kicksat/sprite/Hardware/Sprite_Files/Sprite_Solar_Cells.jpg

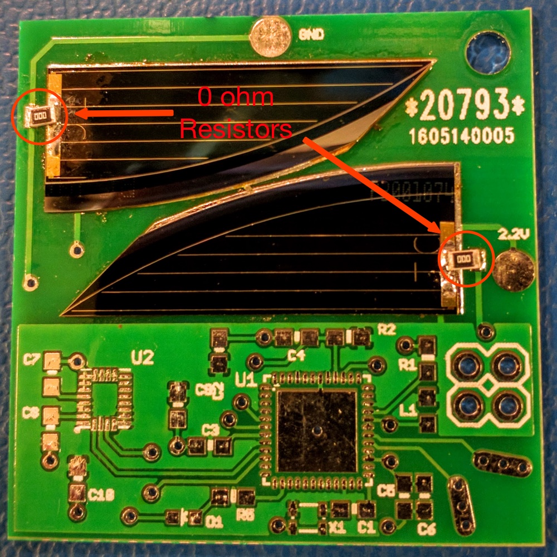
Hardware/Sprite_Files/Sprite_Solar_Cells.jpg
