kicksat/sprite/README.md

# sprite

A tiny open source spacecraft

# License

[Creative Commons Attribution-ShareAlike 4.0 International](https://creativecommons.org/licenses/by-sa/4.0/)
