kicksat/sprite/Sprite_Files/README

Contact for issues/questions:
phone: 607-279-1358
email: zrm3@cornell.edu

Sprite 3 Fab/Assembly Notes:

1. Boards should be scored (no residual tabs on board edges)

2. Solar cells must be reflow soldered on both sides (2 per side, 4 cells total)

3. Zero ohm 0805 resistors must be soldered to connect the top pads on the solar cells to the board. These resistors (R3,R4,R6,R7) are in the BOM but are not included in the centroid files (since our layout software doesn't support this sort of thing). Please have a look at the attached picture (Sprite_Solar_Cells.jpg) to see how they are supposed to be mounted.
