kicksat/sprite/Sprite_Files/SpriteBOM.xlsx

Part | Quantity | Value | Device | Package | Description | DigiKey Part Number
C1, C5, C7 | 3 | 10 nF | CAP0603-CAP | 0603-CAP | CAP CER 10000PF 50V X7R 0603 | 399-1091-1-ND
C2, C3 | 2 | 470nF | CAP0603-CAP | 0603-CAP | CAP CER 0.47UF 10V X5R 0603 | 399-3114-1-ND
C4 | 1 | 2.2nF | CAP0603-CAP | 0603-CAP | CAP CER 2200PF 50V X7R 0603 | 399-1085-1-ND
C6, C8, C9 | 3 | 0.1uF | CAP0603-CAP | 0603-CAP | CAP CER 0.1UF 50V X7R 0603 | 399-5089-1-ND
C10 | 1 | 10uF | CAP0603-CAP | 0603-CAP | CAP CER 10UF 10V X5R 0603 | 490-10475-1-ND
D1 | 1 | LED | LED0603-LED | 0603-LED | LED GREEN DIFFUSED 0603 SMD | 475-2709-1-ND
L1 | 1 | 12 nH | INDUCTOR0603 | 0603-IND | FIXED IND 12NH 300MA 280 MOHM | 587-1546-1-ND
P1, P2 | 2 | SPRITE_PIN | SPRITE_PIN | SPRITE_PIN | TESTPOINT PIN SMD | ED1088CT-ND
R1 | 1 | 56K | RESISTOR0603-RES | 0603-RES | RES SMD 56K OHM 1% 1/10W 0603 | P56.0KHCT-ND
R2 | 1 | 47K | RESISTOR0603-RES | 0603-RES | RES SMD 47K OHM 1% 1/10W 0603 | P47.0KHCT-ND
R3, R4, R6, R7 | 4 | 0R | RESISTOR0805-RES | 0805-RES | RES SMD 0.0 OHM JUMPER 1/8W 0805 | P0.0ACT-ND
R5 | 1 | 270R | RESISTOR0603-RES | 0603-RES | RES SMD 270 OHM 5% 1/10W 0603 | P270GCT-ND
S1, S2, S3, S4 | 4 | TRISOLX-WING | TRISOLX-WING | TRISOLX-T01 | Solar Cell TRISOLX | N/A
U1 | 1 | CC430F5137 | CC430F513X---RGZ48 | RGZ48 | IC MCU 16B 32K W/RF CORE 48VQFN | 296-38903-2-ND
U2 | 1 | LSM9DS1 | LSM9DS1 | LGA24-8X4 | ACCELEROMETER 3D INEMO 24TFLGA | 497-14946-1-ND
X1 | 1 | TCXO_7Z | TCXO_7Z | TXC_7Z | OSC TCXO 26.000MHZ CLPD SNWV SMD | 887-1622-1-ND
