kicksat/sprite/DevBoard_Files/BOM.xlsx

Part | Value | Device | Package | DigiKey Part Number | Manufacturer Part Number
C1 | 27pF | CAP0603-CAP | 0603-CAP | 399-1054-1-ND | C0603C270J5GACTU
C2 | 27pF | CAP0603-CAP | 0603-CAP | 399-1054-1-ND | C0603C270J5GACTU
C3 | 470nF | CAP0603-CAP | 0603-CAP | 399-3114-1-ND | C0603C474K8PACTU
C4 | 470nF | CAP0603-CAP | 0603-CAP | 399-3114-1-ND | C0603C474K8PACTU
C5 | 2.2nF | CAP0603-CAP | 0603-CAP | 399-1085-1-ND | C0603C222K5RACTU
C6 | 100nF | CAP0603-CAP | 0603-CAP | 399-5089-1-ND | C0603C104K5RACTU
C7 | 10nF | CAP0603-CAP | 0603-CAP | 399-1091-1-ND | C0603C103K5RACTU
C8 | 2.2nF | CAP0603-CAP | 0603-CAP | 399-1085-1-ND | C0603C222K5RACTU
C9 | 100nF | CAP0603-CAP | 0603-CAP | 399-5089-1-ND | C0603C104K5RACTU
C10 | 10nF | CAP0603-CAP | 0603-CAP | 399-1091-1-ND | C0603C103K5RACTU
C11 | 100nF | CAP0603-CAP | 0603-CAP | 399-5089-1-ND | C0603C104K5RACTU
C12 | 220nF | CAP0603-CAP | 0603-CAP | 399-1102-1-ND | C0603C224Z4VACTU
C13 | 4.7uF | CAP0603-CAP | 0603-CAP | 399-3482-1-ND | C0603C475K9PACTU
L1 | 12nH | INDUCTOR | 0603-INDUCTOR | 587-1546-1-ND | HK160812NJ-T
LED1 | LED0603 | LED-0603 | 0603-LED | 475-2709-1-ND | LG L29K-G2J1-24-Z
R1 | 56K | RESISTOR0603-RES | 0603-RES | P56.0KHCT-ND | ERJ-3EKF5602V
R2 | 47K | RESISTOR0603-RES | 0603-RES | P47.0KHCT-ND | ERJ-3EKF4702V
R3 | 4.7K | RESISTOR0603-RES | 0603-RES | P4.70KHCT-ND | ERJ-3EKF4701V
R4 | 4.7K | RESISTOR0603-RES | 0603-RES | P4.70KHCT-ND | ERJ-3EKF4701V
R5 | 270R | RESISTOR0603-RES | 0603-RES | P270GCT-ND | ERJ-3GEYJ271V
R6 | 0R | RESISTOR0805-RES | 0805-RES | P0.0ACT-ND | ERJ-6GEY0R00V
R7 | 0R | RESISTOR0805-RES | 0805-RES | P0.0ACT-ND | ERJ-6GEY0R00V
S1 | TASC | TASC | TASC | N/A | N/A
S2` | TASC | TASC | TASC | N/A | N/A
U1 | CC430F5137 | CC430F513X---RGZ48 | QFN-48 | 296-27420-1-ND | CC430F5137IRGZR
U2 | HMC5883LSMD | HMC5883LSMD | 16-LPCC | 342-1082-1-ND | HMC5883L-TR
U3 | ITG-3200 | ITG-3200 | QFN-24 | 37T8091 (Newark) | ITG-3200
X1 | 26MHz | ABM11-XTAL | ABM11_CERAMIC_SMD_CRYSTALABM11 | 535-9815-1-ND | ABM11-26.000MHZ-B7G-T
JP1 | DNP | DNP | DNP
JP2 | DNP | DNP | DNP
JP3 | DNP | DNP | DNP
JP4 | DNP | DNP | DNP
