kicksat/sprite/Replica_Files/Sprite Rep BOM.xlsx

Reference | Quantity | Manufacturer | Part Number | Package | Description | Type
C1, C2 | 2 | Kemet | C0603C270J5GACTU | 0603 | Cap 27 pF | DNS
C3, C4 | 2 | Kemet | C0603C474K8PACTU | 0603 | Cap 470 nF | SMT
C5 | 1 | Yageo | CC0603KRX7R9BB222 | 0603 | Cap 2.2 nF | SMT
C6 | 1 | Panasonic |  | 0603 | Cap 100 nF | DNS
C7 | 1 | Panasonic |  | 0603 | Cap 10 nF | DNS
L1 | 1 | Taiyo Yuden | HK160812NJ-T | 0603 | Inductor 32 nH | DNS
R1 | 1 | Panasonic | ERJ-3EKF5602V | 0603 | Resistor 56K | SMT
R2 | 1 | Panasonic | ERJ-3EKF4702V | 0603 | Resistor 47K | SMT
R3, R4, R5, R6, R7, R8 | 6 | Panasonic | ERJ-3GEYJ271V | 0603 | Resistor 270R | SMT
D1, D2, D3, D4, D5, D6 | 6 | Osram | LG L29K-G2J1-24-Z | 0603 | LED | SMT
S1 | 1 | Spectrolab |  | TASC | Soalar Cell | DNS
U1 | 1 | Texas Instruments | CC430F5137IRGZR | 48-QFN | MCU/Radio SoC | Fine Pitch
X1 | 1 |  |  | ABM11 | Crystal 26MHz | DNS
