kicksat/sprite/Sprite.brd

## EAGLE design Sprite.brd (2016-06-01)

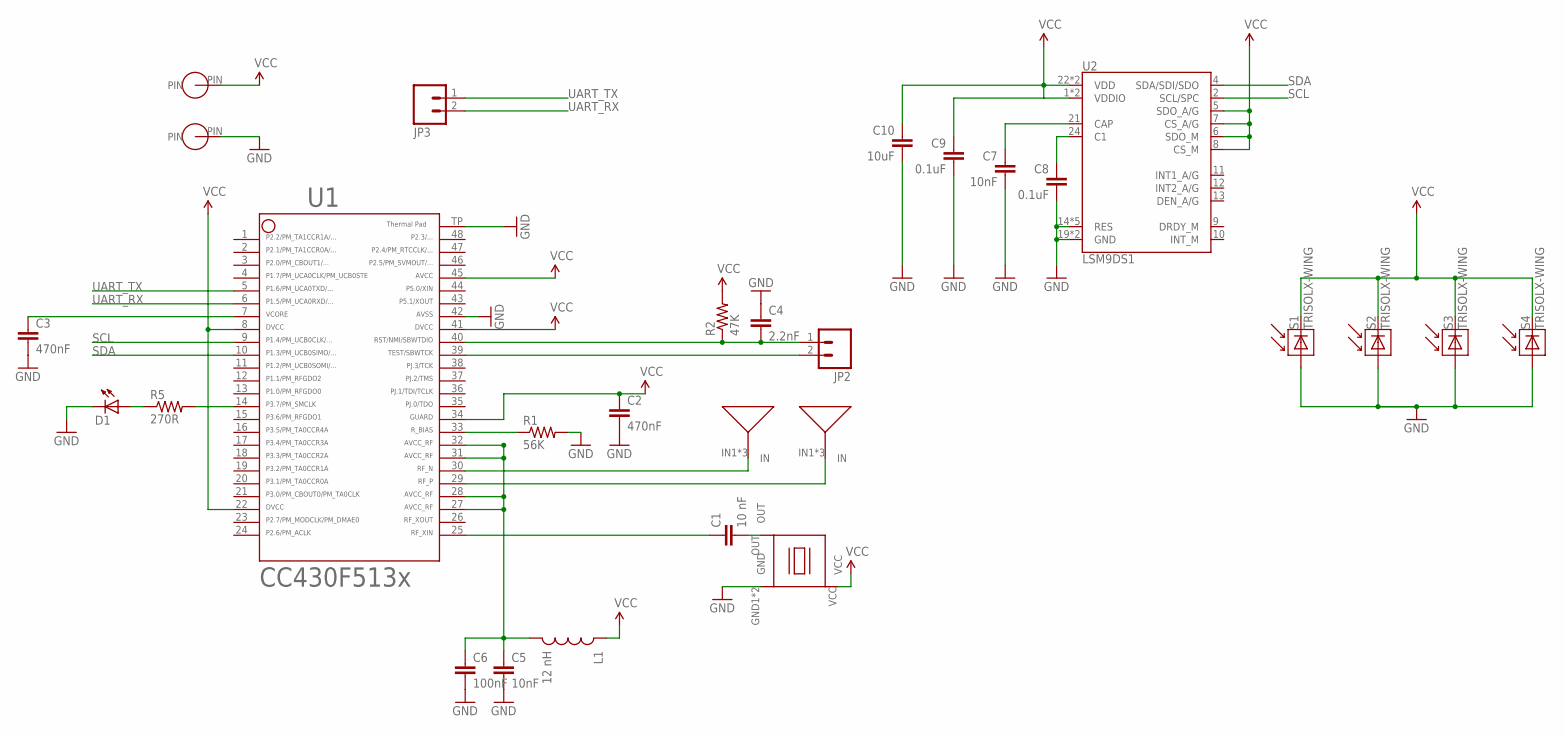
[picture p3: schematic Sprite.sch, sheet 1]

Parts:
ANT-N: ANTENNA
ANT-P: ANTENNA
C1: 10 nF; 0603-CAP
C2, C3: 470nF; 0603-CAP
C4: 2.2nF; 0603-CAP
C5, C7: 10nF; 0603-CAP
C6: 100nF; 0603-CAP
C8, C9: 0.1uF; 0603-CAP
C10: 10uF; 0603-CAP
D1: LED0603; LED-0603
JP2, JP3: M02PTH; 1X02
L1: 12 nH; 0603
P1, P2: SPRITE_PIN
R1: 56K; 0603-RES
R2: 47K; 0603-RES
R5: 270R; 0603-RES
S1, S2, S3, S4: TRISOLX-WING; TRISOLX-T01
U1: CC430F5137; RGZ48
U2: LSM9DS1; LGA24-8X4
X1: TCXO_7Z; TXC_7Z

Connections:
GND: C2.2, C3.2, C4.1, C5.2, C6.2, C7.2, C8.2, C9.2, C10.2, D1.C, P1.PIN, R1.2, S1.P$3 (A), S2.P$3 (A), S3.P$3 (A), S4.P$3 (A), U1.42, U1.TP (49), U2.14 (RES), U2.15 (RES), U2.16 (RES), U2.17 (RES), U2.18 (RES), U2.19 (GND), U2.20 (GND), X1.GND1 (GND), X1.GND2 (GND)
unnamed: C1.1, U1.25
unnamed: R5.2, U1.14
unnamed: R1.1, U1.33
unnamed: C3.1, U1.7
unnamed: C7.1, U2.21 (CAP)
unnamed: C8.1, U2.24 (C1)
unnamed: D1.A, R5.1
unnamed: C1.2, X1.OUT
RFN: ANT-N.IN1, ANT-N.IN2, ANT-N.IN3, U1.30
RFP: ANT-P.IN1, ANT-P.IN2, ANT-P.IN3, U1.29
RST: C4.2, JP2.1, R2.1, U1.40
SCL: U1.9, U2.2 (SCL/SPC)
SDA: U1.10, U2.4 (SDA/SDI/SDO)
TEST: JP2.2, U1.39
UART_RX: JP3.2, U1.6
UART_TX: JP3.1, U1.5
VCC: C2.1, C9.1, C10.1, L1.1, P2.PIN, R2.2, S1.P$2 (C), S2.P$2 (C), S3.P$2 (C), S4.P$2 (C), U1.8, U1.22, U1.34, U1.41, U1.45, U2.1 (VDDIO), U2.3 (VDDIO), U2.5 (SDO_A/G), U2.6 (SDO_M), U2.7 (CS_A/G), U2.8 (CS_M), U2.22 (VDD), U2.23 (VDD), X1.VCC
VCCRF: C5.1, C6.1, L1.2, U1.27, U1.28, U1.31, U1.32

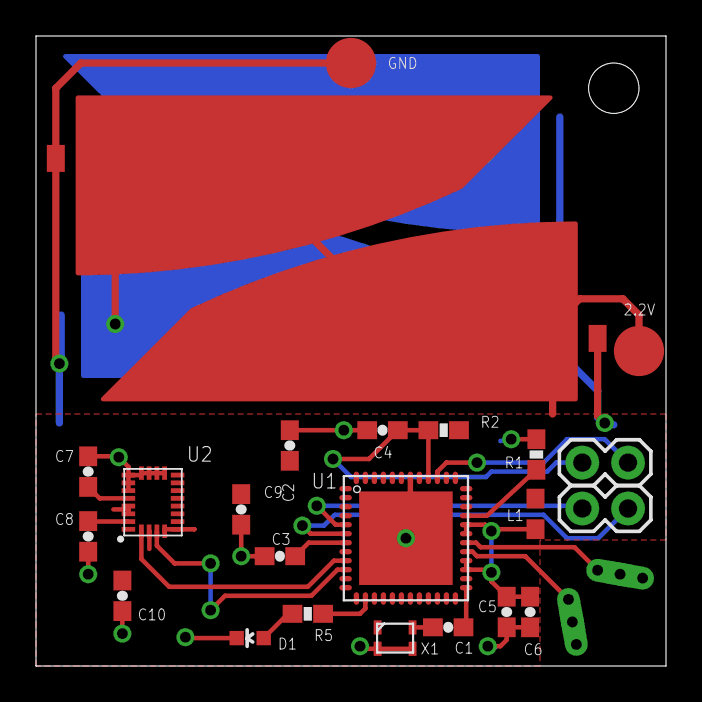
[picture p4: board Sprite.brd from above]

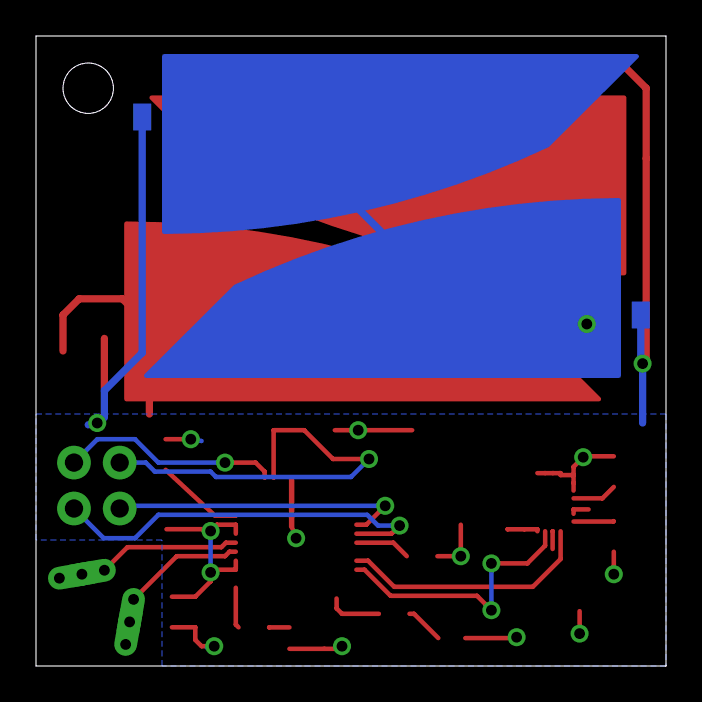
[picture p5: board Sprite.brd from below]

Board: 2 copper layers, 35.0 x 35.0 mm, 28 parts (2 on the bottom side), 19 nets.
