kicksat/sprite/Programmer.brd

## EAGLE design Programmer.brd (2014-06-02)

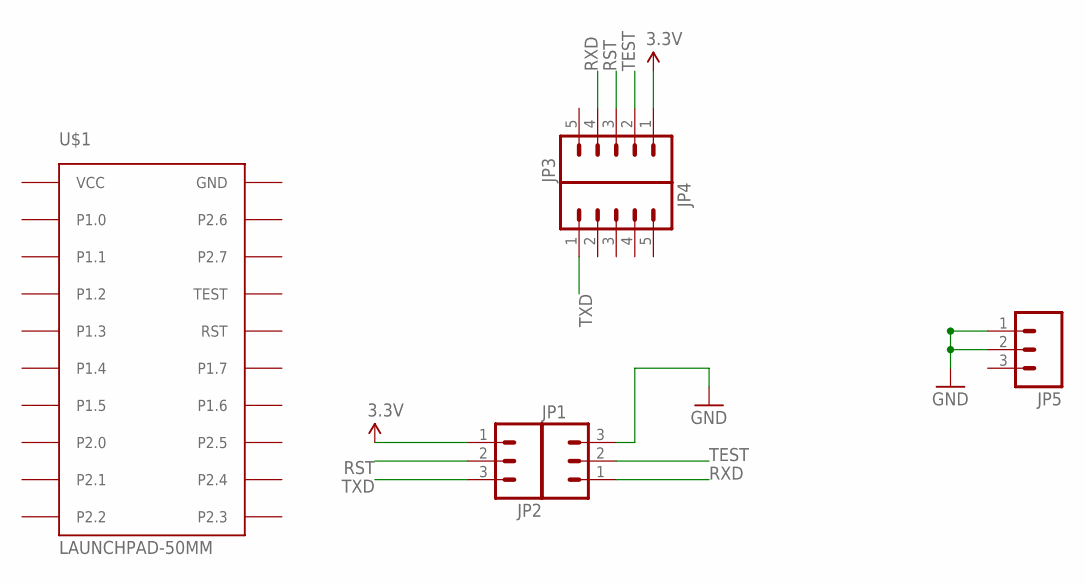
[picture p6: schematic Programmer.sch]

Parts:
JP1, JP2, JP5: M03LOCK; 1X03_LOCK
JP3, JP4: M05LOCK; 1X05_LOCK
U$1: LAUNCHPAD-50MM

Connections:
3.3V: JP2.1, JP3.1
GND: JP1.3, JP5.1, JP5.2, U$1.GND
RST: JP2.2, JP3.3
RXD: JP1.1, JP3.4
TEST: JP1.2, JP3.2
TXD: JP2.3, JP4.1
VCC: U$1.VCC

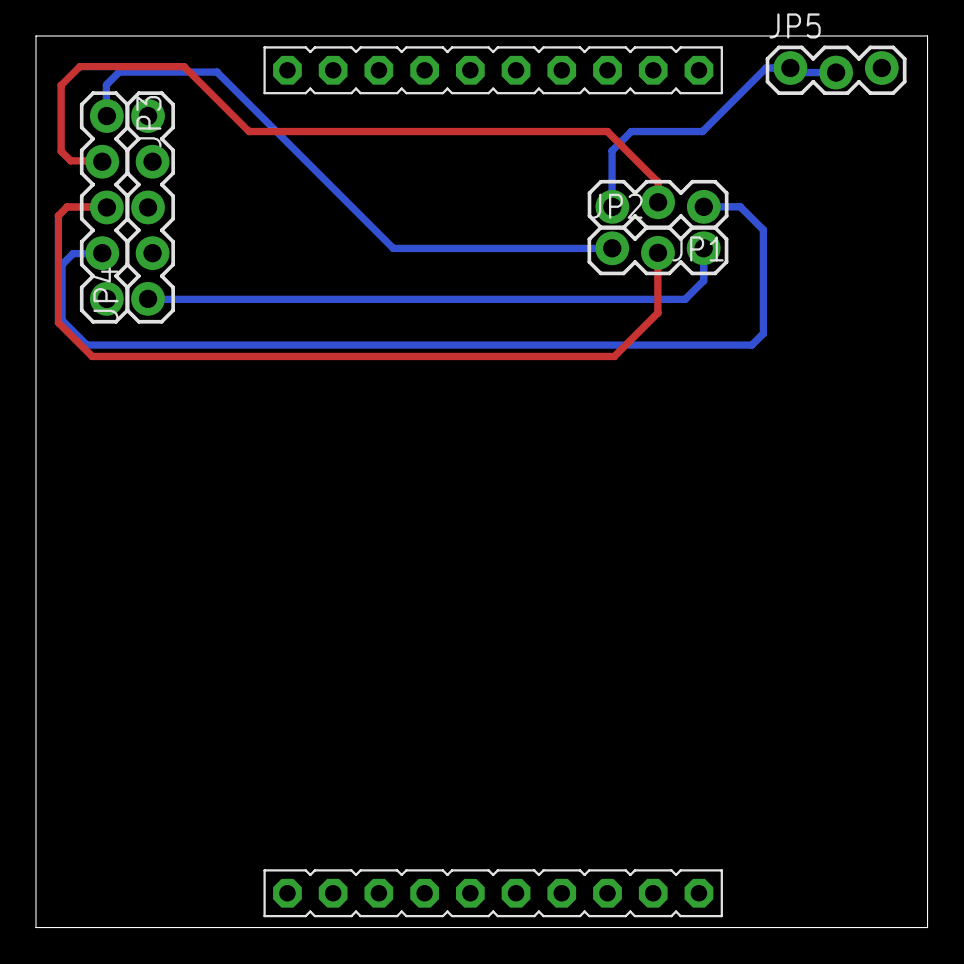
[picture p7: board Programmer.brd from above]

Board: 2 copper layers, 49.5 x 49.5 mm, 6 parts (0 on the bottom side), 6 nets.
