kicksat/sprite/Replica.brd

## EAGLE design Replica.brd (2014-06-02)

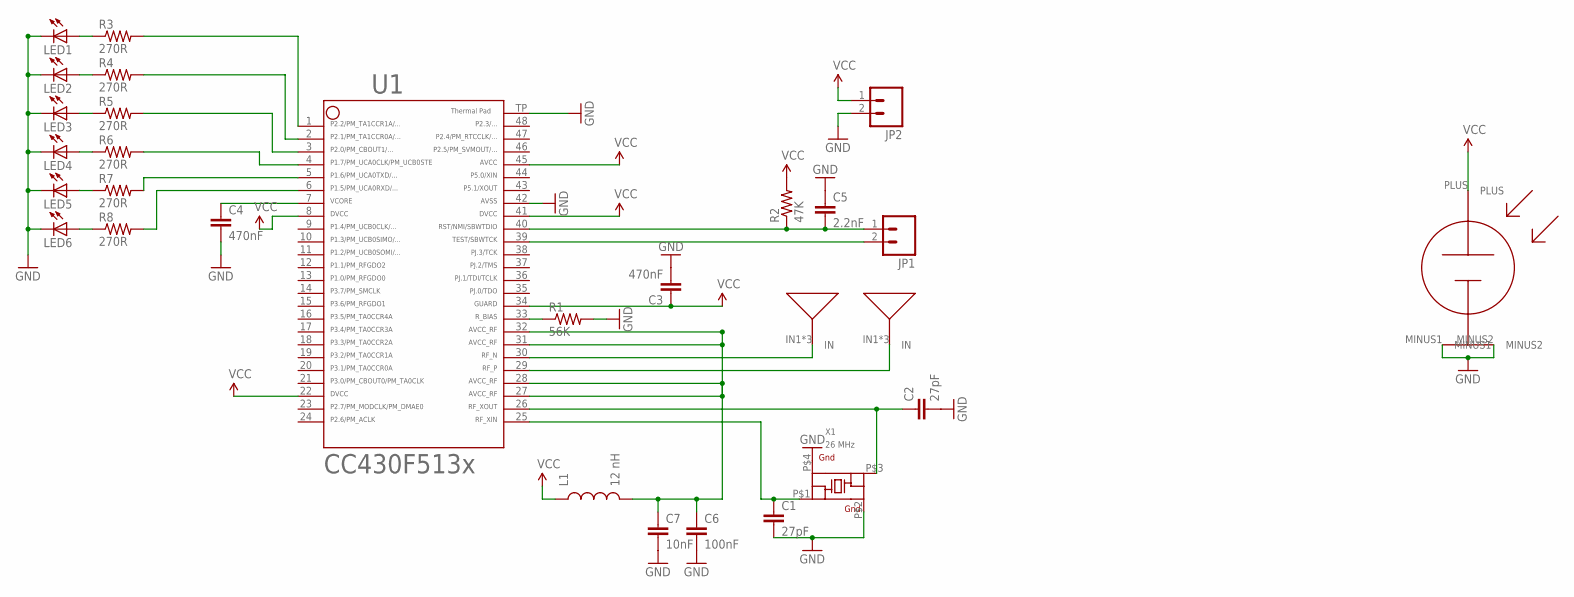
[picture p8: schematic Replica.sch]

Parts:
ANT-N: ANTENNA
ANT-P: ANTENNA
C1, C2: 27pF; 0603-CAP
C3, C4: 470nF; 0603-CAP
C5: 2.2nF; 0603-CAP
C6: 100nF; 0603-CAP
C7: 10nF; 0603-CAP
JP1, JP2: M02PTH; 1X02
L1: 12 nH; 0603
LED1, LED2, LED3, LED4, LED5, LED6: LED0603; LED-0603
R1: 56K; 0603-RES
R2: 47K; 0603-RES
R3, R4, R5, R6, R7, R8: 270R; 0603-RES
S1: TASC
U1: CC430F5137; RGZ48
X1: 26 MHz; ABM11_CERAMIC-SMD-CRYSTAL

Connections:
GND: C1.2, C2.2, C3.2, C4.2, C5.1, C6.2, C7.2, JP2.2, LED1.C, LED2.C, LED3.C, LED4.C, LED5.C, LED6.C, R1.2, S1.MINUS1, S1.MINUS2, U1.42, U1.TP (49), X1.P$2 (GROUND2), X1.P$4 (GROUND4)
unnamed: C2.1, U1.26, X1.P$3
unnamed: C1.1, U1.25, X1.P$1
unnamed: R1.1, U1.33
unnamed: R4.2, U1.2
unnamed: LED2.A, R4.1
unnamed: LED3.A, R5.1
unnamed: LED4.A, R6.1
unnamed: LED5.A, R7.1
unnamed: LED6.A, R8.1
unnamed: R3.2, U1.1
unnamed: LED1.A, R3.1
unnamed: R5.2, U1.3
unnamed: R6.2, U1.4
unnamed: R7.2, U1.5
unnamed: R8.2, U1.6
RFN: ANT-N.IN1, ANT-N.IN2, ANT-N.IN3, U1.30
RFP: ANT-P.IN1, ANT-P.IN2, ANT-P.IN3, U1.29
RST: C5.2, JP1.1, R2.1, U1.40
TEST: JP1.2, U1.39
VCC: C3.1, JP2.1, L1.1, R2.2, S1.PLUS, U1.8, U1.22, U1.34, U1.41, U1.45
VCCRF: C6.1, C7.1, L1.2, U1.27, U1.28, U1.31, U1.32
VCORE: C4.1, U1.7

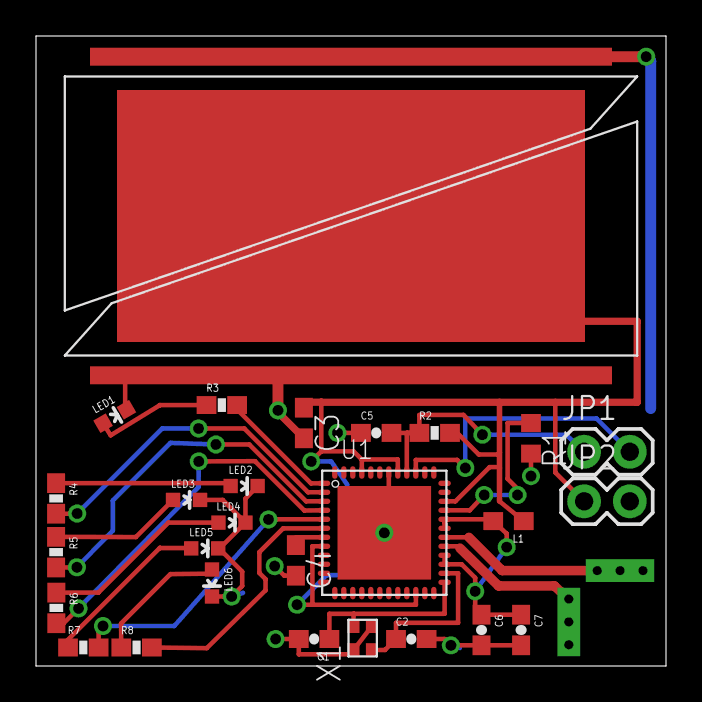
[picture p9: board Replica.brd from above]

Board: 2 copper layers, 35.0 x 35.0 mm, 29 parts (0 on the bottom side), 23 nets.
