kicksat/sprite/DevBoard.brd

## EAGLE design DevBoard.brd (2014-06-02)

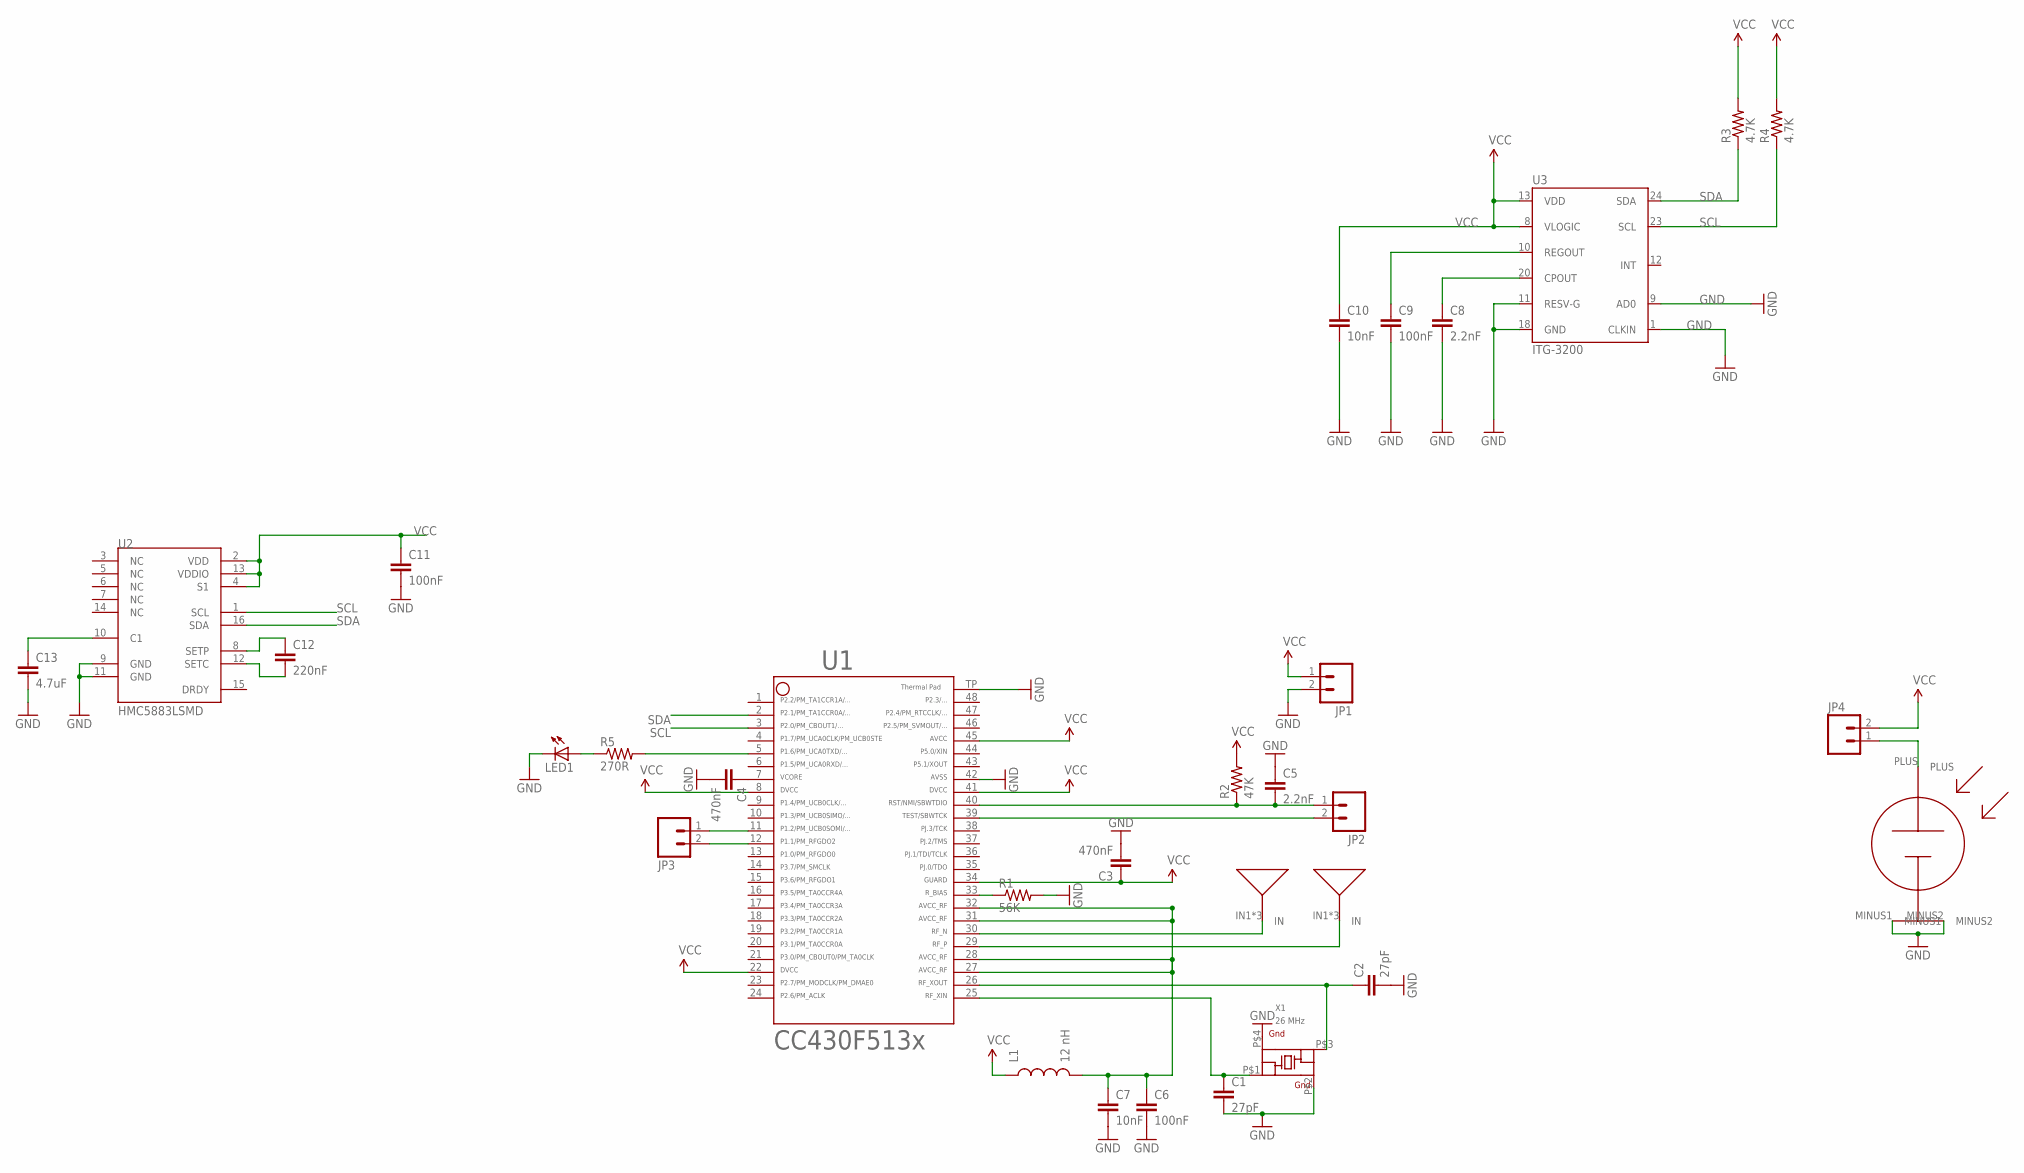
[picture p10: schematic DevBoard.sch]

Parts:
ANT-N: ANTENNA
ANT-P: ANTENNA
C1, C2: 27pF; 0603-CAP
C3, C4: 470nF; 0603-CAP
C5, C8: 2.2nF; 0603-CAP
C6, C9, C11: 100nF; 0603-CAP
C7, C10: 10nF; 0603-CAP
C12: 220nF; 0603-CAP
C13: 4.7uF; 0603-CAP
JP1, JP2, JP3, JP4: M02PTH; 1X02
L1: 12 nH; 0603
LED1: LED0603; LED-0603
R1: 56K; 0603-RES
R2: 47K; 0603-RES
R3, R4: 4.7K; 0603-RES
R5: 270R; 0603-RES
S1: TASC
U1: CC430F5137; RGZ48
U2: HMC5883LSMD; 16LPCC
U3: ITG-3200; QFN-24
X1: 26 MHz; ABM11_CERAMIC-SMD-CRYSTAL

Connections:
GND: C1.2, C2.2, C3.2, C4.2, C5.1, C6.2, C7.2, C8.2, C9.2, C10.2, C11.2, C13.2, JP1.2, LED1.C, R1.2, S1.MINUS1, S1.MINUS2, U1.42, U1.TP (49), U2.9 (GND), U2.11 (GND), U3.1 (CLKIN), U3.9 (AD0), U3.11 (RESV-G), U3.18 (GND), X1.P$2 (GROUND2), X1.P$4 (GROUND4)
unnamed: C2.1, U1.26, X1.P$3
unnamed: C1.1, U1.25, X1.P$1
unnamed: R1.1, U1.33
unnamed: C4.1, U1.7
unnamed: C12.1, U2.8 (SETP)
unnamed: C12.2, U2.12 (SETC)
unnamed: C13.1, U2.10 (C1)
unnamed: C8.1, U3.20 (CPOUT)
unnamed: C9.1, U3.10 (REGOUT)
unnamed: R5.2, U1.5
unnamed: LED1.A, R5.1
RFN: ANT-N.IN1, ANT-N.IN2, ANT-N.IN3, U1.30
RFP: ANT-P.IN1, ANT-P.IN2, ANT-P.IN3, U1.29
RST: C5.2, JP2.1, R2.1, U1.40
RXD: JP3.2, U1.12
SCL: R4.1, U1.3, U2.1 (SCL), U3.23 (SCL)
SDA: R3.1, U1.2, U2.16 (SDA), U3.24 (SDA)
TEST: JP2.2, U1.39
TXD: JP3.1, U1.11
VCC: C3.1, C10.1, C11.1, JP1.1, JP4.2, L1.1, R2.2, R3.2, R4.2, U1.8, U1.22, U1.34, U1.41, U1.45, U2.2 (VDD), U2.4 (S1), U2.13 (VDDIO), U3.8 (VLOGIC), U3.13 (VDD)
VCCRF: C6.1, C7.1, L1.2, U1.27, U1.28, U1.31, U1.32
VSOLAR: JP4.1, S1.PLUS

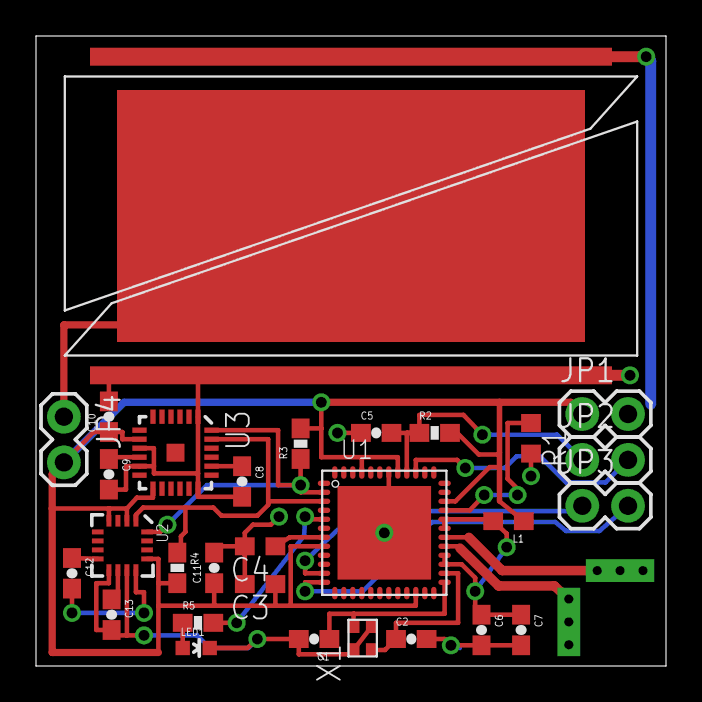
[picture p11: board DevBoard.brd from above]

Board: 2 copper layers, 35.0 x 35.0 mm, 31 parts (0 on the bottom side), 23 nets.
