kicksat/sprite/Software/Test_Code/GyroDemo/GyroDemo.ino

#include <SpriteGyro.h>
#include <SpriteRadio.h>

unsigned char prn2[64] = {
  0b00000001, 0b01011110, 0b11010100, 0b01100001, 0b00001011, 0b11110011, 0b00110001, 0b01011100,
  0b01100110, 0b10010010, 0b01011011, 0b00101010, 0b11100000, 0b10100011, 0b00000000, 0b11100001,
  0b10111011, 0b10011111, 0b00110001, 0b11001111, 0b11110111, 0b11000000, 0b10110010, 0b01110101,
  0b10101010, 0b10100111, 0b10100101, 0b00010010, 0b00001111, 0b01011011, 0b00000010, 0b00111101,
  0b01001110, 0b01100000, 0b10001110, 0b00010111, 0b00110100, 0b10000101, 0b01100001, 0b01000101,
  0b00000110, 0b10100010, 0b00110110, 0b00101111, 0b10101001, 0b00011111, 0b11010111, 0b11111101,
  0b10011101, 0b01001000, 0b00011001, 0b00011000, 0b10101111, 0b00110110, 0b10010011, 0b00000000,
  0b00010000, 0b10000101, 0b00101000, 0b00011101, 0b01011100, 0b10101111, 0b01100100, 0b11011010
};

unsigned char prn3[64] = {
  0b11111101, 0b00111110, 0b01110111, 0b11010101, 0b00100101, 0b11101111, 0b00101100, 0b01101001,
  0b00101010, 0b11101001, 0b00111100, 0b11000100, 0b00000111, 0b10010011, 0b11000101, 0b00000111,
  0b00110111, 0b00011111, 0b01111011, 0b11010001, 0b10111010, 0b00000111, 0b10010000, 0b00110111,
  0b11011111, 0b01011010, 0b11101101, 0b11001000, 0b10001100, 0b01101001, 0b10010111, 0b00101001,
  0b10101100, 0b11011001, 0b11010110, 0b00011010, 0b11010110, 0b10101000, 0b00000101, 0b11010011,
  0b01101010, 0b11001011, 0b11010110, 0b01010010, 0b00111111, 0b11100111, 0b10000010, 0b10000110,
  0b01101110, 0b10011010, 0b01100101, 0b10100110, 0b00101110, 0b01010100, 0b11110100, 0b01111010,
  0b11001011, 0b00101110, 0b01100011, 0b10111111, 0b01010100, 0b11000100, 0b11010100, 0b01010100
};

//Initialize the radio class, supplying the Gold Codes that correspond to 0 and 1
SpriteRadio radio = SpriteRadio(prn2, prn3);
SpriteGyro gyro = SpriteGyro();

void setup() {
  gyro.init();
  radio.txInit();
  Serial.begin(9600);
}

void loop() {
  
  AngularVelocity w = gyro.read();
  
  Serial.print("x: ");
  Serial.print(w.x);
  Serial.print("    y:");
  Serial.print(w.y);
  Serial.print("    z: ");
  Serial.println(w.z);
  
  float wz = w.z/14.375;
  
  char wz_string[5];
  
  sprintf(wz_string,"%3i",int(wz));
  wz_string[4] = '\n';
  
  radio.transmit(wz_string,5);
}
