kicksat/sprite/(commit log)

2014-06-02 Initial move
    [BOM.xlsx, DevBoard.brd, DevBoard.sch, DevBoard_centroid.csv, Programmer.brd, Programmer.sch, Replica centroid.csv, Replica.brd]
2014-07-24 Updated GyroDemo
2016-04-19 Fixed inconsistency between .brd and .sch
    [Sprite.brd, Sprite.sch]
2016-04-24 Adding IMU + TrisolX parts
2016-04-27 Rolled my own motor driver
    [Sprite.brd, Sprite.sch]
2016-04-27 Revert "Rolled my own motor driver"
    This reverts commit 8d15a71afd97314b3e3036af91b9c243df8797f7.
    [Sprite.brd, Sprite.sch]
2016-05-12 Sprite layout with TrisolX
    [Sprite.brd, Sprite.sch]
2016-05-12 Finished new layout
    [Sprite.brd]
2016-05-13 Swapped pins
    [Sprite.brd, Sprite.sch]
2016-05-20 Updated files for fab
    [Sprite.brd, Sprite.sch, SpriteBOM.xlsx, Sprite_centroid.csv]
2016-05-20 Added Centroid data
    [SpriteBOM.xlsx, Sprite_centroid.csv]
2016-05-26 Fixed part numbering (duplicate R5)
    [SpriteBOM.xlsx]
2016-06-01 Update TrisolX footprint
    [Sprite.brd, Sprite.sch]
2018-07-20 All things sprite compiled
    [BOM.xlsx, DevBoard.brd, DevBoard.sch, DevBoard_centroid.csv, Programmer.brd, Programmer.sch, Replica centroid.csv, Replica.brd]
2018-10-08 Revert "All things sprite compiled"
    This reverts commit 57d04d4f7100c9d78c9e83d719de1b6c8f8ca531.
    [BOM.xlsx, DevBoard.brd, DevBoard.sch, DevBoard_centroid.csv, Programmer.brd, Programmer.sch, Replica centroid.csv, Replica.brd]
